CalvEngIO/PulseFit/GFX/Hardware/PulseFit-GFX.png

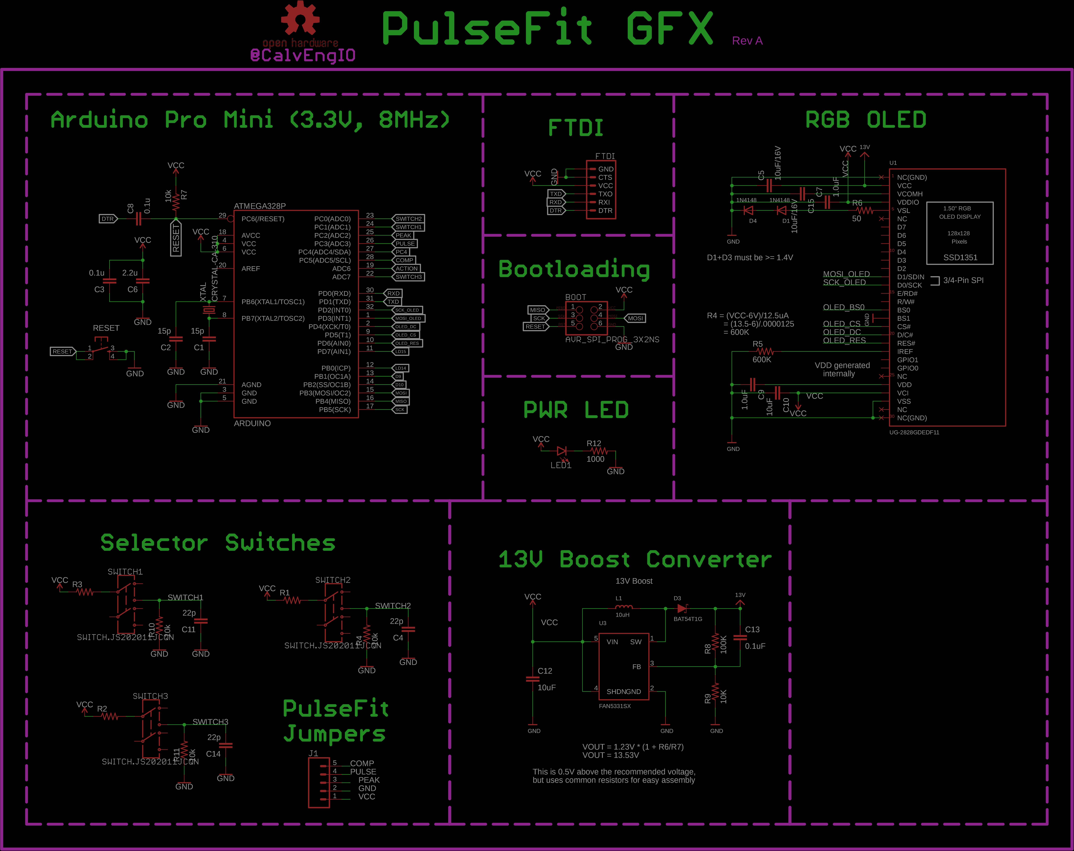
GFX/Hardware/PulseFit-GFX.png
