CalvEngIO/PulseFit/PulseFit/PulseFit-BOM.xlsx

@CalvEngIO PulseFit Rev F |  |  |  |  |  |  |  |  |  |  | Total | $8.11
BOM # | Comment | Designator | Description | Mounting Type | Package | Manufacturer | Manufacturer Part Number | Supplier | Supplier Part Number | Price per unit | Quantity | Price Total
1 | APDS-9008 | PD | Optical Sensor Ambient 565nm Current 6-SMD, No Lead | SMD | 6-SMD, No Lead | Broadcom Limited | APDS-9008-020 | Digi-Key | 516-2662-1-ND | $1.24 | 1 | $1.24
2 | Green Illumination LED | LED1 | Green 525nm LED Indication - Discrete 3.3V 2-SMD, Z-Bend | SMD | 2-SMD, Z-Bend | Kingbright | AM2520ZGC09 | Digi-Key | 754-1423-1-ND | $0.78 | 1 | $0.78
3 | MCP6004 | AMP | General Purpose Amplifier 4 Circuit Rail-to-Rail 14-TSSOP | SMD | 14-TSSOP | Microchip Technology | MCP6004T-I/ST | Digi-Key | MCP6004T-I/STCT-ND | $0.45 | 1 | $0.45
4 | Red LED | LED2,LED3,LED4,LED5,LED6,LED7,LED8,LED9,LED10,LED11,LED12,LED13,LED14,LED15,LED16,LED17,LED18,LED19 | Chanzon 100 pcs 5mm Red LED Diode Lights (Clear Round Transparent DC 2V 20mA) Super Bright Lighting Bulb Lamps Electronics Components Light Emitting Diodes | THT | THT | CHANZON | 100F5T-YT-WH-RE | Amazon | B01AUI4WC8 | $0.07 | 18 | $1.18 | $0.07 | $0.07 | $0.07 | $0.07 | $0.07 | $1.18 | $1.18 | $1.18 | $1.18 | $1.18 | $0.00 | $0.00 | $0.00 | $0.00 | $0.00
5 | JST Connector | LIPO | JST Right Angle Connector - White | SMD | NA | 4UCOM Technology Inc. |  | Sparkfun Electronics | PRT-08612 | $0.95 | 1 | $0.95
6 | On/Off Switch | SW1 | SWITCH SLIDE DPDT 300MA 6V | SMD | 6-J Lead | C&K | JS202011JCQN | Digi-Key | CKN10723CT-ND | $0.48 | 1 | $0.48
7 | Schottky Diode | D1 | Diode Schottky 30V 1.5A Surface Mount USC | SMD | USC | Toshiba Semiconductor and Storage | CUS15S30,H3F | Digi-Key | CUS15S30H3FCT-ND | $0.43 | 2 | $0.86
8 | 105 Ohms | R8 | ±1% 0.063W, 1/16W Chip Resistor 0402 (1005 Metric) Moisture Resistant Thick Film | SMD | 0402 | Yageo | RC0402FR-07105RL | Digi-Key | YAG2947CT-ND | $0.10 | 1 | $0.10
9 | 487 Ohms | R1 | ±1% 0.063W, 1/16W Chip Resistor 0402 (1005 Metric) Moisture Resistant Thick Film | SMD | 0402 | Yageo | RC0402FR-07487RL | Digi-Key | YAG2373CT-ND | $0.10 | 1 | $0.10
10 | 10k | R2,R3 | ±1% 0.063W, 1/16W Chip Resistor 0402 (1005 Metric) Moisture Resistant Thick Film | SMD | 0402 | Yageo | RC0402FR-0710K2L | Digi-Key | YAG2950CT-ND | $0.10 | 2 | $0.20
11 | 205k resistor | R4,R5,R9,R10 | ±1% 0.063W, 1/16W Chip Resistor 0402 (1005 Metric) Moisture Resistant Thick Film | SMD | 0402 | Yageo | RC0402FR-07205KL | Digi-Key | YAG3050CT-ND | $0.10 | 4 | $0.40
12 | 1.47M resistor | R7 | ±1% 0.063W, 1/16W Chip Resistor 0402 (1005 Metric) Moisture Resistant Thick Film | SMD | 0402 | Samsung Electro-Mechanics America, Inc. | RC1005F1474CS | Digi-Key | 1276-4291-1-ND | $0.10 | 1 | $0.10
13 | 3.3M | R6 | ±1% 0.063W, 1/16W Chip Resistor 0402 (1005 Metric) Moisture Resistant Thick Film | SMD | 0402 | Yageo | RC0402FR-073M3L | Digi-Key | 311-3.30MLRCT-ND | $0.10 | 1 | $0.10
14 | 2.2uF | C1,C2,C3,C8 | 2.2µF ±10% 16V Ceramic Capacitor X5R 0603 (1608 Metric) | SMD | 0603 | Murata Electronics North America | GRM188R61C225KE15D | Digi-Key | 490-3296-1-ND | $0.13 | 4 | $0.52
15 | 4.7uF | C5,C6,C7 | 4.7µF ±10% 10V Ceramic Capacitor X5R 0603 (1608 Metric) | SMD | 0603 | Samsung Electro-Mechanics America, Inc. | CL10A475KP8NNNC | Digi-Key | 1276-1044-1-ND | $0.14 | 3 | $0.42
16 | 10uF | C9 | 10µF ±10% 16V Ceramic Capacitor X5R 0805 (2012 Metric) | SMD | 0805 | Samsung Electro-Mechanics America, Inc. | CL21A106KOQNNNG | Digi-Key | 1276-6455-1-ND | $0.13 | 1 | $0.13
17 | 100pF | C4 | 100pF ±5% 50V Ceramic Capacitor C0G, NP0 0402 (1005 Metric) | SMD | 0402 | Samsung Electro-Mechanics America, Inc. | CL05C101JB5NNNC | Digi-Key | 1276-1025-1-ND | $0.10 | 1 | $0.10
