CalvEngIO/PulseFit/GFX/Hardware/PulseFit-GFX.brd

## EAGLE design GFX/Hardware/PulseFit-GFX.brd (2021-04-02)

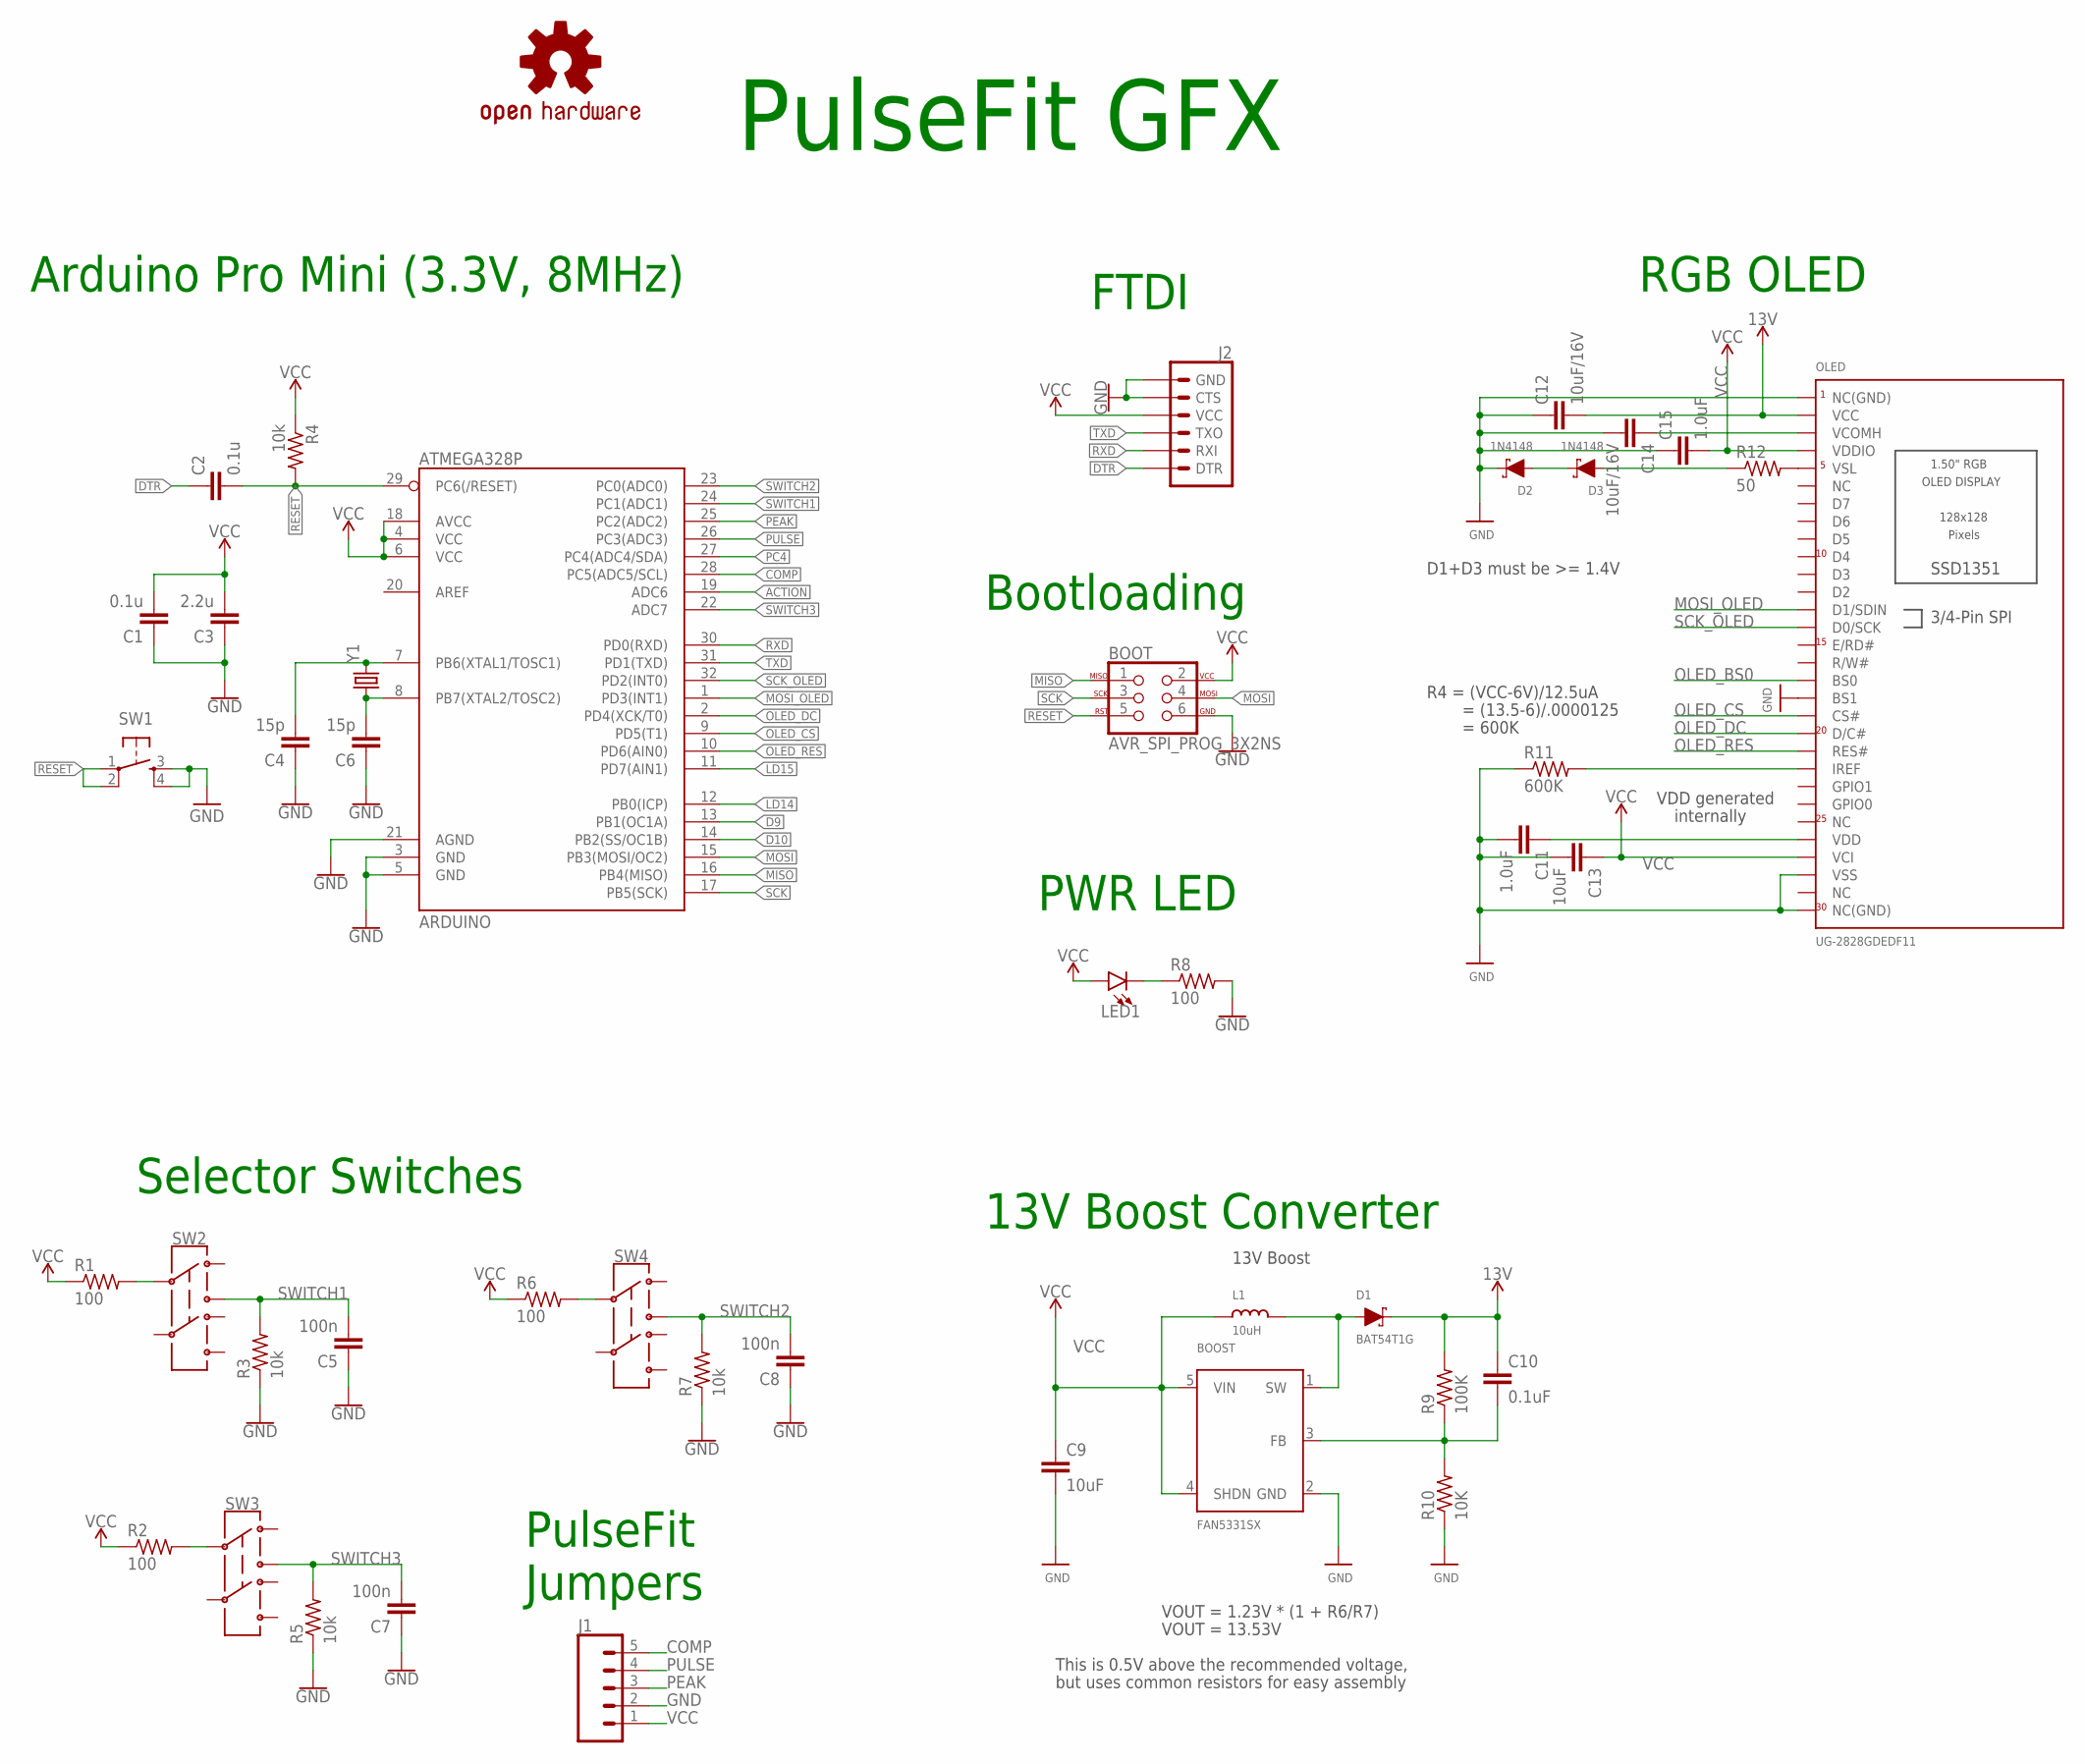
[picture p2: schematic PulseFit-GFX.sch]

Parts:
ARDUINO: ATMEGA328P; TQFP32-08
BOOST: FAN5331SX; SOT23-5@1
BOOT: AVR_SPI_PROG_3X2NS; 2X3-NS
C1, C2: 0.1u; C0603
C3: 2.2u; C0805
C4, C6: 15p; C0603
C5, C7, C8: 100n; C0603
C9, C13: 10uF; C0805
C10: 0.1uF; C0603
C11, C15: 1.0uF; C0603
C12, C14: 10uF/16V; C0805
D1: BAT54T1G; USC
D2, D3: 1N4148; USC
J1: CONN_05; 1X05
J2: 6_PIN_SERIAL_TARGETSILK; 6_PIN_SERIAL_TARGET_SIDE_W_SILK
L1: 10uH; INDUCTOR_1007
LED1: LED5MM; LED_5MM
LOGO1: CALVENGIO_HANDLEHANDLE.05; CALVENGIO_HANDLE.05
LOGO2: OSHW-LOGOS; OSHW-LOGO-S
LOGO3: REVISION.A; REV.A
OLED: UG-2828GDEDF11; FPC_XF2M-3015-1A
R1, R2, R6, R8: 100; R0603
R3, R4, R5, R7: 10k; R0603
R9: 100K; R0603
R10: 10K; R0603
R11: 600K; R0603
R12: 50; R0603
SW1: SPST-PTS830GG140; BUTTON-GULLWING
SW2, SW3, SW4: SWITCH.JS202011JXQNUPWARDS; SWITCH.00
Y1: CRYSTAL-CA-310; CA-301

Connections:
13V: C10.1, C12.2, D1.- (C), OLED.P$29 (VCC), R9.2
ACTION: ARDUINO.19 (ADC6)
COMP: ARDUINO.28 (PC5(ADC5/SCL)), J1.5
D9: ARDUINO.13 (PB1(OC1A))
D10: ARDUINO.14 (PB2(SS/OC1B))
DTR: C2.1, J2.P$1 (DTR)
GND: ARDUINO.3 (GND), ARDUINO.5 (GND), ARDUINO.21 (AGND), BOOST.2 (GND), BOOT.6, C1.1, C3.1, C4.1, C5.1, C6.1, C7.1, C8.1, C9.2, C11.2, C12.1, C13.2, C14.2, C15.1, D2.- (C), J1.2, J2.P$5 (CTS), J2.P$6 (GND), OLED.P$1 (NC(GND)), OLED.P$3 (VSS), OLED.P$13 (BS1), OLED.P$30 (NC(GND)), R3.1, R5.1, R7.1, R8.2, R10.1, R11.1, SW1.3, SW1.4
IREF: OLED.P$9 (IREF), R11.2
LD14: ARDUINO.12 (PB0(ICP))
LD15: ARDUINO.11 (PD7(AIN1))
MISO: ARDUINO.16 (PB4(MISO)), BOOT.1
MOSI: ARDUINO.15 (PB3(MOSI/OC2)), BOOT.4
MOSI_OLED: ARDUINO.1 (PD3(INT1)), OLED.P$18 (D1/SDIN)
unnamed: ARDUINO.7 (PB6(XTAL1/TOSC1)), C4.2, Y1.2
unnamed: ARDUINO.8 (PB7(XTAL2/TOSC2)), C6.2, Y1.1
unnamed: LED1.K (C), R8.1
unnamed: C11.1, OLED.P$5 (VDD)
unnamed: BOOST.1 (SW), D1.+ (A), L1.P$2 (2)
unnamed: OLED.P$26 (VSL), R12.2
unnamed: D3.+ (A), R12.1
unnamed: BOOST.3 (FB), C10.2, R9.1, R10.2
unnamed: R6.2, SW4.2
unnamed: R2.2, SW3.2
unnamed: R1.2, SW2.2
unnamed: D2.+ (A), D3.- (C)
OLED_BS0: OLED.P$14 (BS0)
OLED_CS: ARDUINO.9 (PD5(T1)), OLED.P$12 (CS#)
OLED_DC: ARDUINO.2 (PD4(XCK/T0)), OLED.P$11 (D/C#)
OLED_RES: ARDUINO.10 (PD6(AIN0)), OLED.P$10 (RES#)
PC4: ARDUINO.27 (PC4(ADC4/SDA))
PEAK: ARDUINO.25 (PC2(ADC2)), J1.3
PULSE: ARDUINO.26 (PC3(ADC3)), J1.4
RESET: ARDUINO.29 (PC6(/RESET)), BOOT.5, C2.2, R4.2, SW1.1, SW1.2
RXD: ARDUINO.30 (PD0(RXD)), J2.P$3 (RXI)
SCK: ARDUINO.17 (PB5(SCK)), BOOT.3
SCK_OLED: ARDUINO.32 (PD2(INT0)), OLED.P$17 (D0/SCK)
SWITCH1: ARDUINO.24 (PC1(ADC1)), C5.2, R3.2, SW2.3
SWITCH2: ARDUINO.23 (PC0(ADC0)), C8.2, R7.2, SW4.3
SWITCH3: ARDUINO.22 (ADC7), C7.2, R5.2, SW3.3
TXD: ARDUINO.31 (PD1(TXD)), J2.P$2 (TXO)
VCC: ARDUINO.4 (VCC), ARDUINO.6 (VCC), ARDUINO.18 (AVCC), BOOST.4 (SHDN), BOOST.5 (VIN), BOOT.2, C1.2, C3.2, C9.1, C13.1, C15.2, J1.1, J2.P$4 (VCC), L1.P$1 (1), LED1.A, OLED.P$4 (VCI), OLED.P$27 (VDDIO), R1.1, R2.1, R4.1, R6.1
VCOMH1: C14.1, OLED.P$28 (VCOMH)

Notes on the sheet:
FTDI
Bootloading
VOUT = 1.23V * (1 + R6/R7)
VOUT = 13.53V
This is 0.5V above the recommended voltage,
but uses common resistors for easy assembly
13V Boost
R4 = (VCC-6V)/12.5uA
= (13.5-6)/.0000125
= 600K
D1+D3 must be >= 1.4V
VDD generated
internally
Arduino Pro Mini (3.3V, 8MHz)
RGB OLED
13V Boost Converter
Selector Switches
PulseFit Jumpers
PWR LED
PulseFit GFX

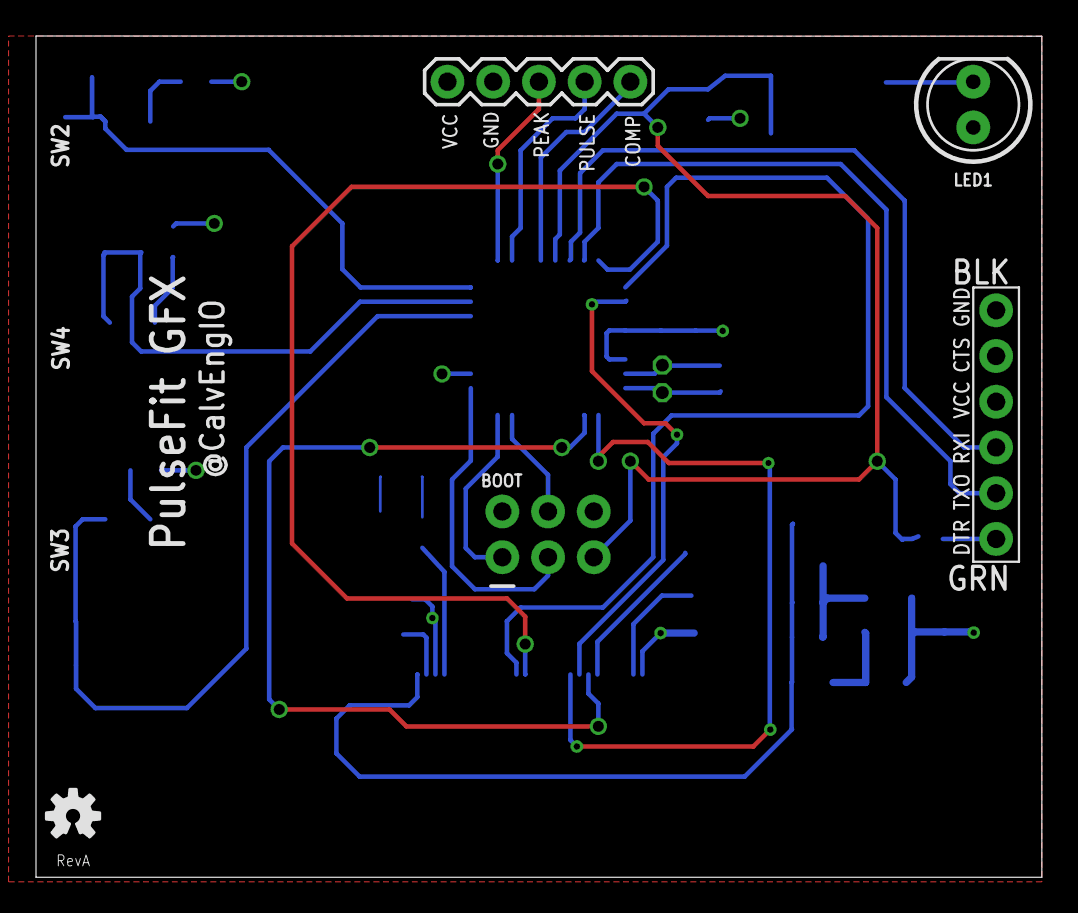
[picture p3: board PulseFit-GFX.brd from above]

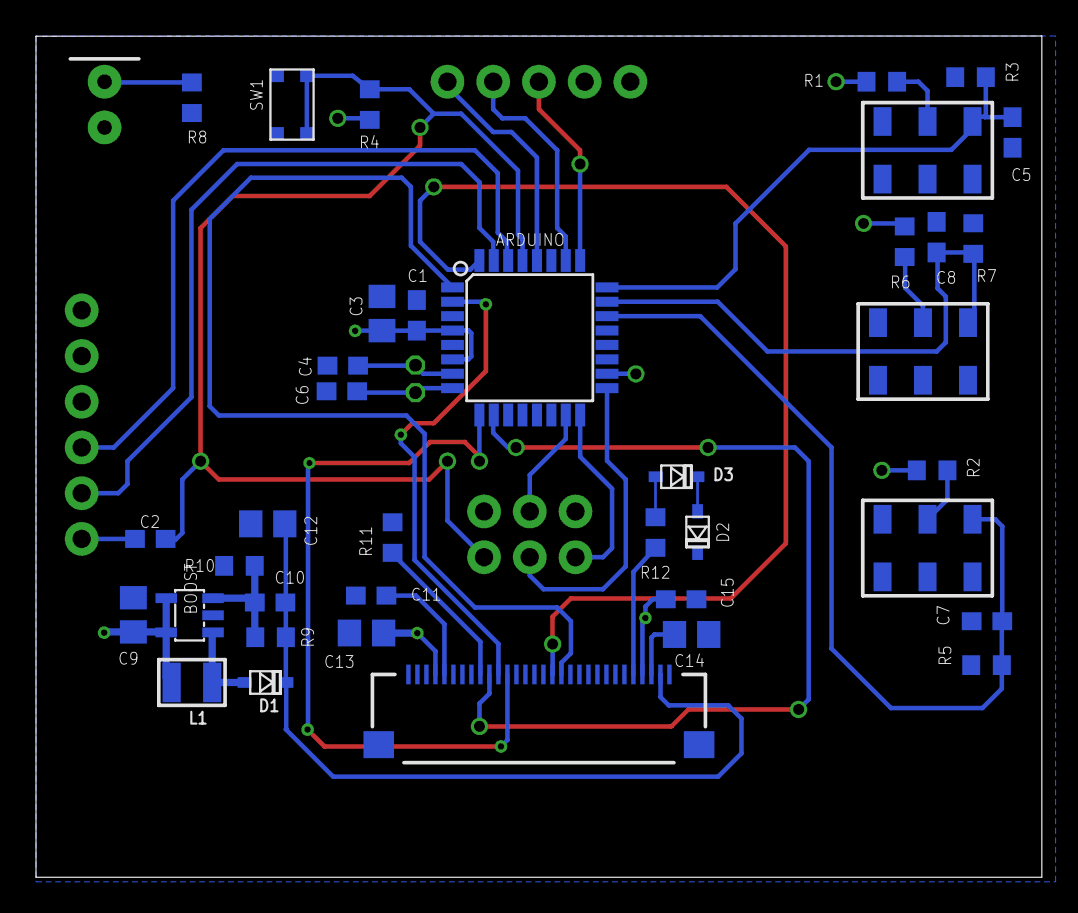
[picture p4: board PulseFit-GFX.brd from below]

Board: 2 copper layers, 55.9 x 46.7 mm, 46 parts (38 on the bottom side), 35 nets.
