CalvEngIO/PulseFit/PulseFit/PulseFit.brd

## EAGLE design PulseFit/PulseFit.brd (2021-04-02)

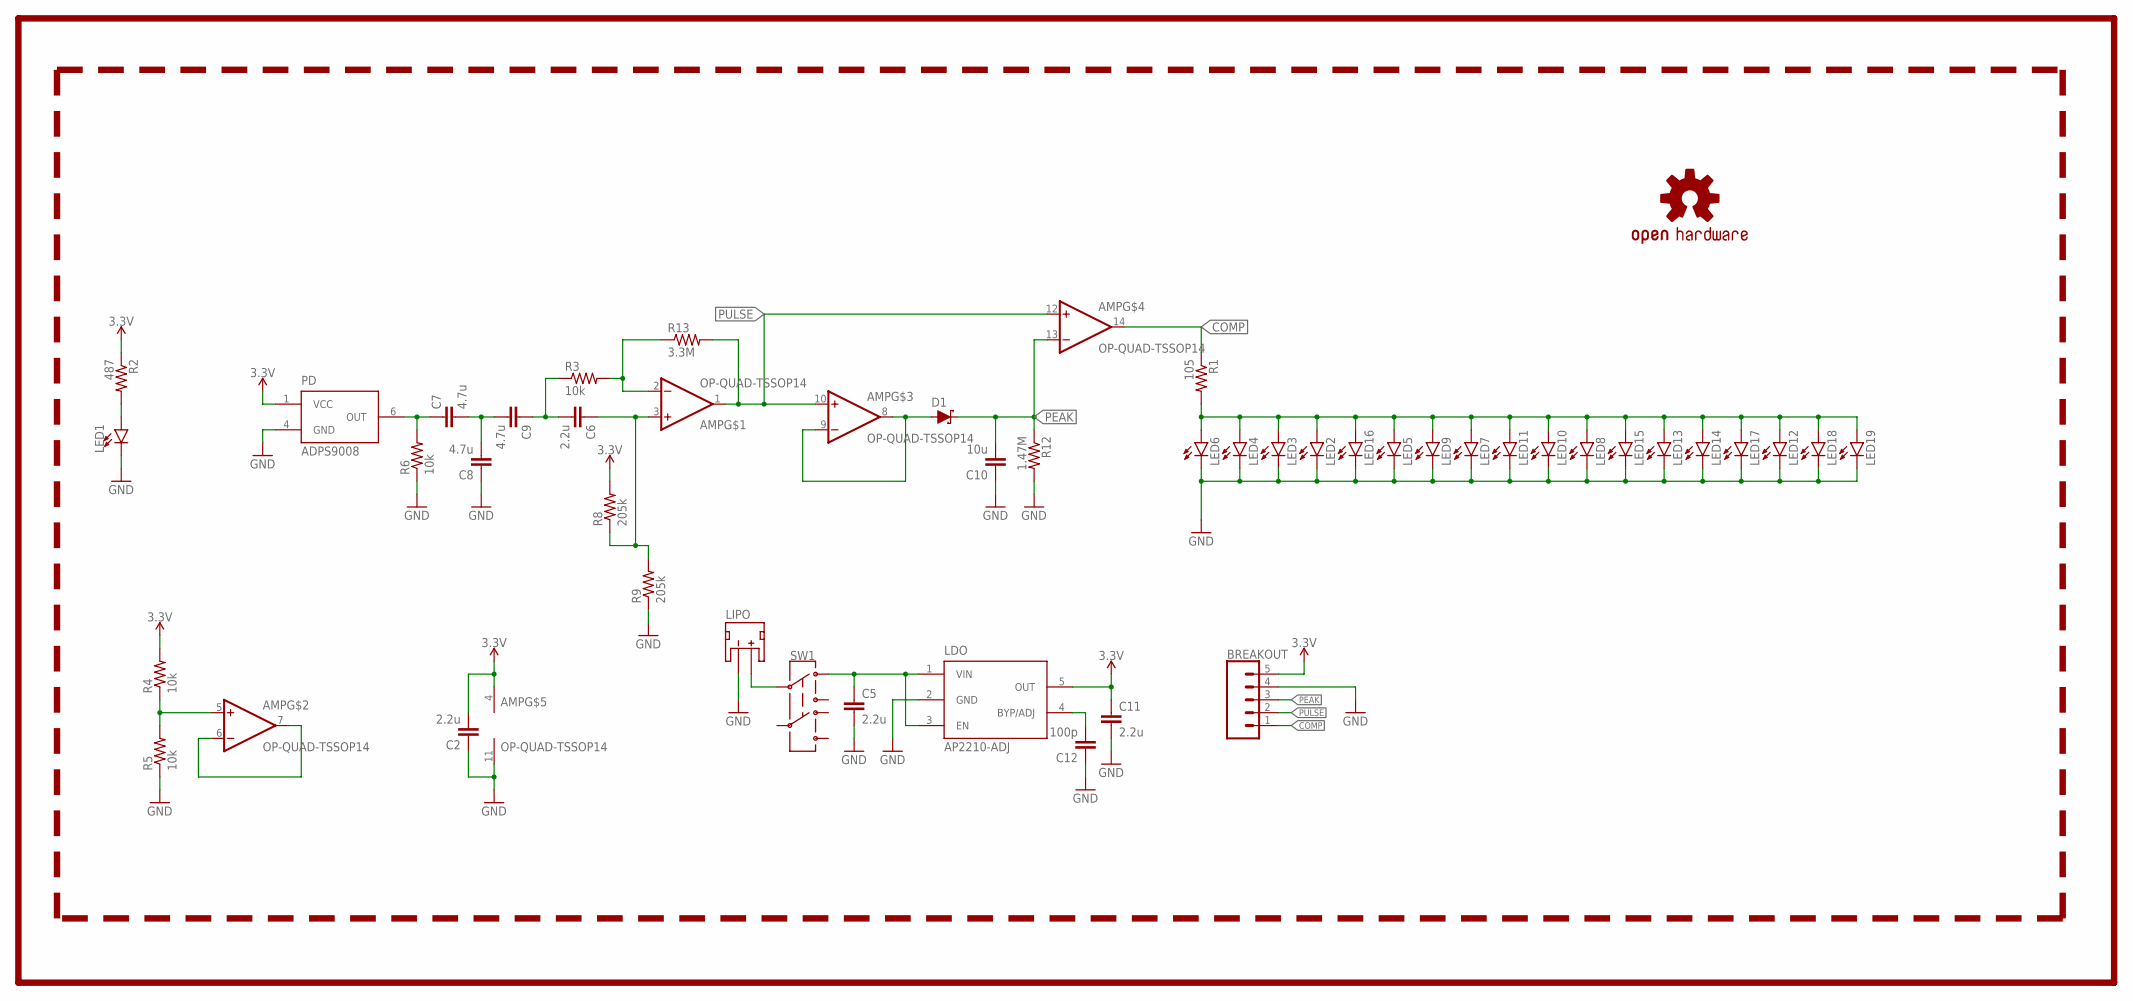
[picture p5: schematic PulseFit.sch]

Parts:
AMP: OP-QUAD-TSSOP14; TSSOP14
BREAKOUT: CONN_05NO_SILK; 1X05_NO_SILK
C2: 2.2u; C0402
C5, C6, C11: 2.2u; C0603
C7, C8, C9: 4.7u; C0603
C10: 10u; C0805
C12: 100p; C0402
D1: SCHOTTKY-USC; USC
LDO: AP2210-ADJ; SOT23-5
LED1: LEDZ-BEND; 2-SMD.Z-BEND
LED2, LED3, LED4, LED5, LED6, LED7, LED8, LED9, LED10, LED11, LED12, LED13, LED14, LED15, LED16, LED17, LED18, LED19: LED5MM
LIPO: JST_2MM_MALE; JST-2-SMD
LOGO1: OSHW-LOGOS; OSHW-LOGO-S
PD: ADPS9008; 6-PIN.CHIPLED
R1: 105; R0402
R2: 487; R0402
R3, R4, R5, R6: 10k; R0402
R8, R9: 205k; R0402
R12: 1.47M; R0402
R13: 3.3M; R0402
SW1: SWITCH.JS202011JCQN; SWITCH.00
U$1: CALVENGIO_HANDLEHANDLE.05; CALVENGIO_HANDLE.05
U$2: REVISION.F; REV.F

Connections:
3.3V: AMP.4 (V+), BREAKOUT.5, C2.2, C11.1, LDO.5 (OUT), PD.1 (VCC), R2.1, R4.2, R8.2
ANODE: LED2.A, LED3.A, LED4.A, LED5.A, LED6.A, LED7.A, LED8.A, LED9.A, LED10.A, LED11.A, LED12.A, LED13.A, LED14.A, LED15.A, LED16.A, LED17.A, LED18.A, LED19.A, R1.2
COMP: AMP.14 (OUT), BREAKOUT.1, R1.1
GND: AMP.11 (V-), BREAKOUT.4, C2.1, C5.2, C8.1, C10.1, C11.2, C12.1, LDO.2 (GND), LED1.- (C), LED2.K (C), LED3.K (C), LED4.K (C), LED5.K (C), LED6.K (C), LED7.K (C), LED8.K (C), LED9.K (C), LED10.K (C), LED11.K (C), LED12.K (C), LED13.K (C), LED14.K (C), LED15.K (C), LED16.K (C), LED17.K (C), LED18.K (C), LED19.K (C), LIPO.1 (-), PD.4 (GND), R5.1, R6.1, R9.1, R12.2
unnamed: AMP.5 (+IN), R4.1, R5.2
unnamed: AMP.6 (-IN), AMP.7 (OUT)
unnamed: C12.2, LDO.4 (BYP/ADJ)
unnamed: LIPO.2 (+), SW1.2
unnamed: LED1.+ (A), R2.2
unnamed: AMP.8 (OUT), AMP.9 (-IN), D1.+ (A)
unnamed: C5.1, LDO.1 (VIN), LDO.3 (EN), SW1.1
unnamed: C7.2, C8.2, C9.2
unnamed: C6.2, C9.1, R3.1
unnamed: AMP.2 (-IN), R3.2, R13.1
unnamed: AMP.3 (+IN), C6.1, R8.1, R9.2
unnamed: C7.1, PD.6 (OUT), R6.2
PEAK: AMP.13 (-IN), BREAKOUT.3, C10.2, D1.- (C), R12.1
PULSE: AMP.1 (OUT), AMP.10 (+IN), AMP.12 (+IN), BREAKOUT.2, R13.2

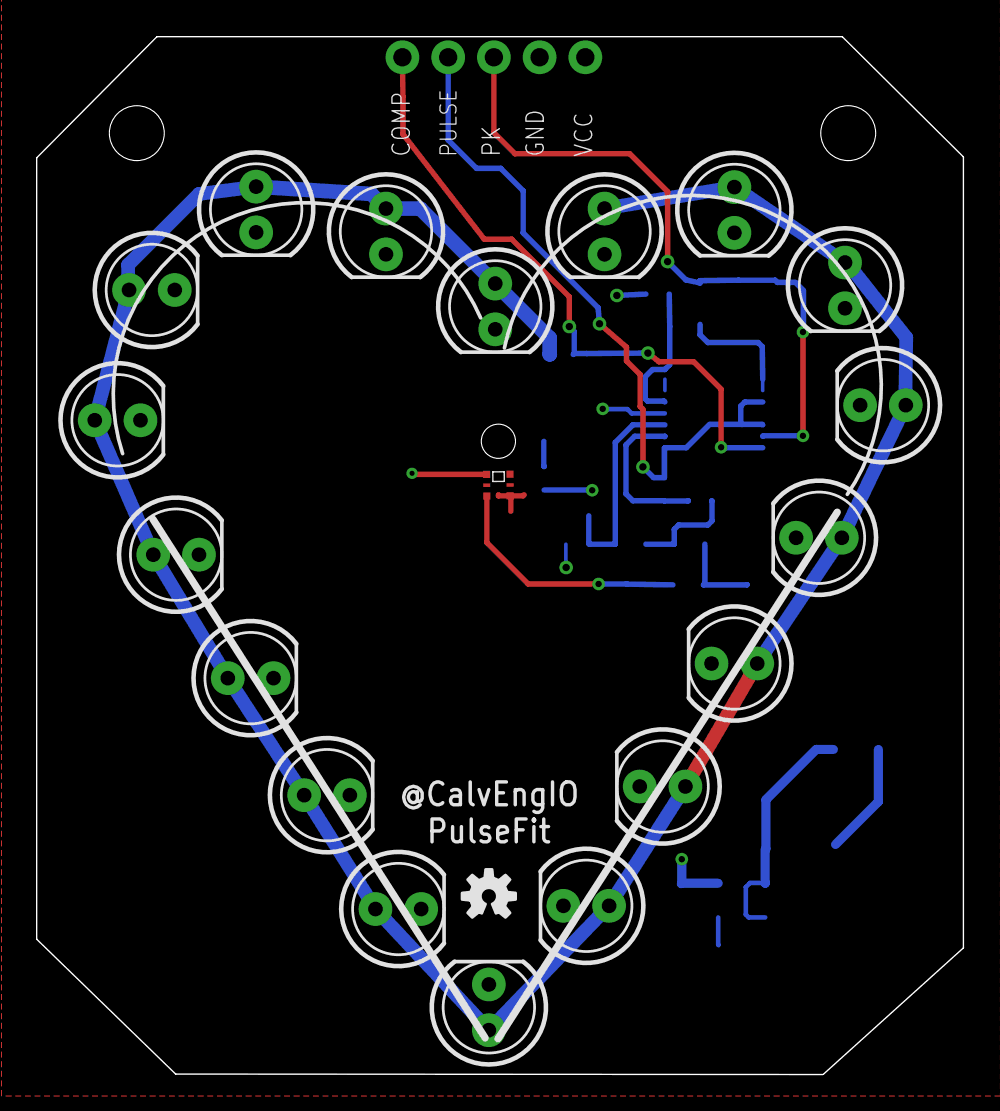
[picture p6: board PulseFit.brd from above]

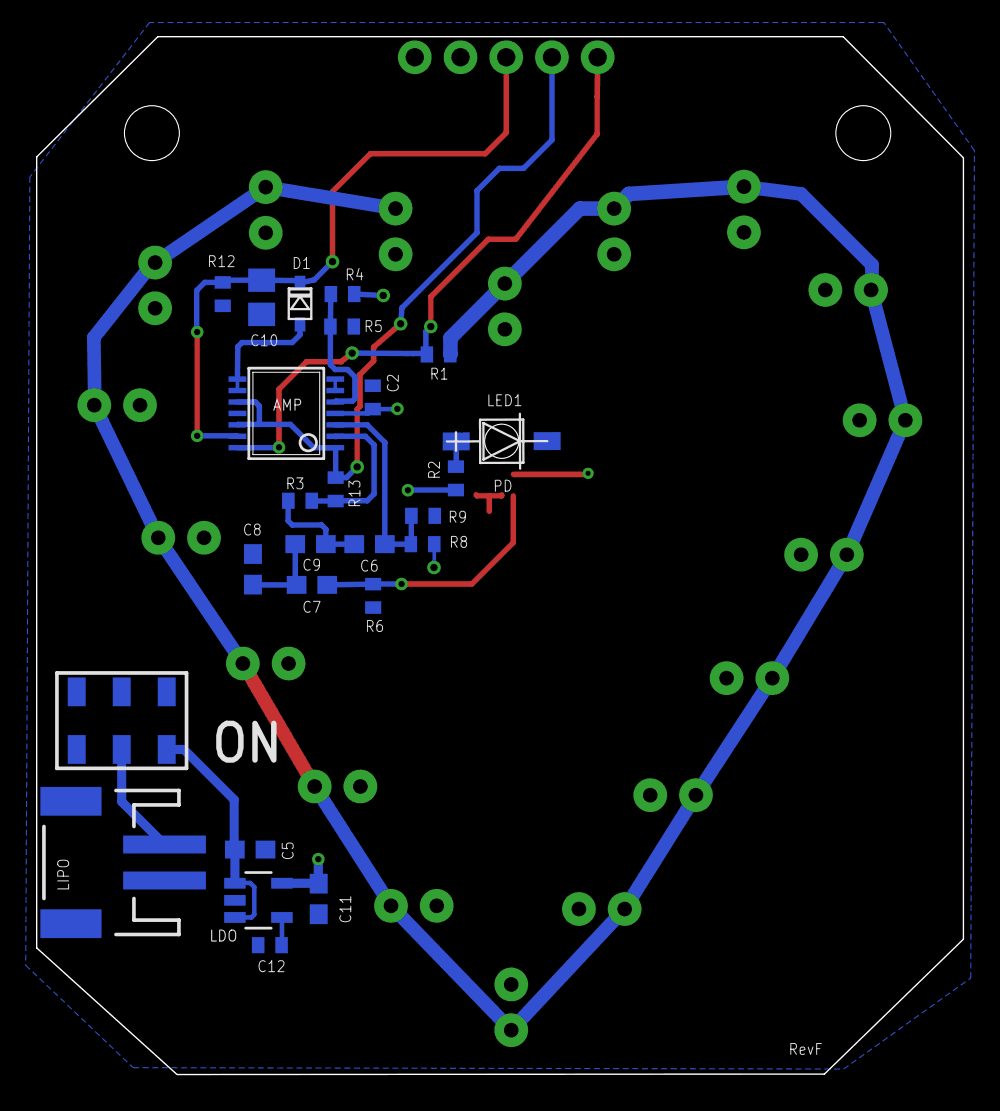
[picture p7: board PulseFit.brd from below]

Board: 2 copper layers, 51.5 x 57.7 mm, 48 parts (26 on the bottom side), 18 nets.
