CalvEngIO/PulseFit/(commit log)

2017-06-07 initial commit with first iteration of the schematic
    [PulseFit.brd, PulseFit.sch]
2017-06-13 first itteration of pulsefit
    [PulseFit.brd, PulseFit.sch]
2017-06-22 next board
    [PulseFit.brd]
2017-07-10 deleted extra bypass capacitors and changed their values a bit
    [PulseFit.brd, PulseFit.sch]
2017-07-10 slight updates moving capacitors around and such
    [PulseFit.brd, PulseFit.sch]
2017-08-13 these are the most up to date files, but new versions soon to come
    [PulseFit-Bottom.sch]
2017-08-13 most up to date files, but more to come
    [PulseFit-Bottom.brd]
2021-04-02 reorganized and regrouped repo
    [PulseFit-BOM.xlsx, PulseFit-GFX-BOM.xlsx, PulseFit-GFX.brd, PulseFit-GFX.sch, PulseFit.brd, PulseFit.sch]
2021-04-03 documenting small change before bigger change
    [PulseFit.sch]
